alex-aprm/TeslaAmbientLight/images/connector-door3.png

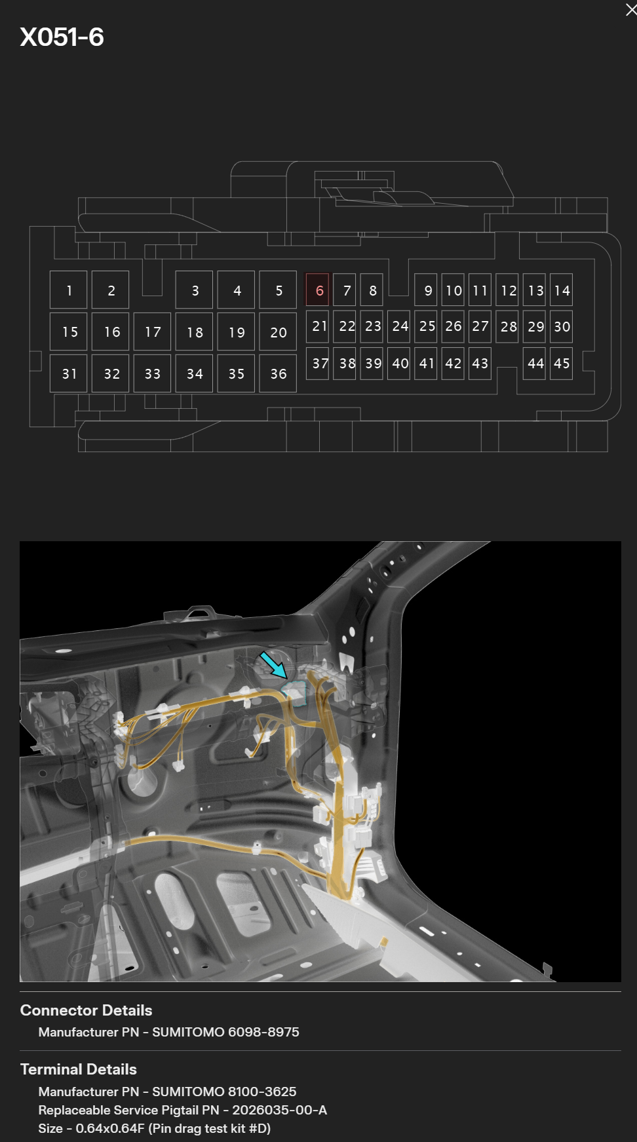
images/connector-door3.png
