alex-aprm/TeslaAmbientLight/images/door-wiring.png

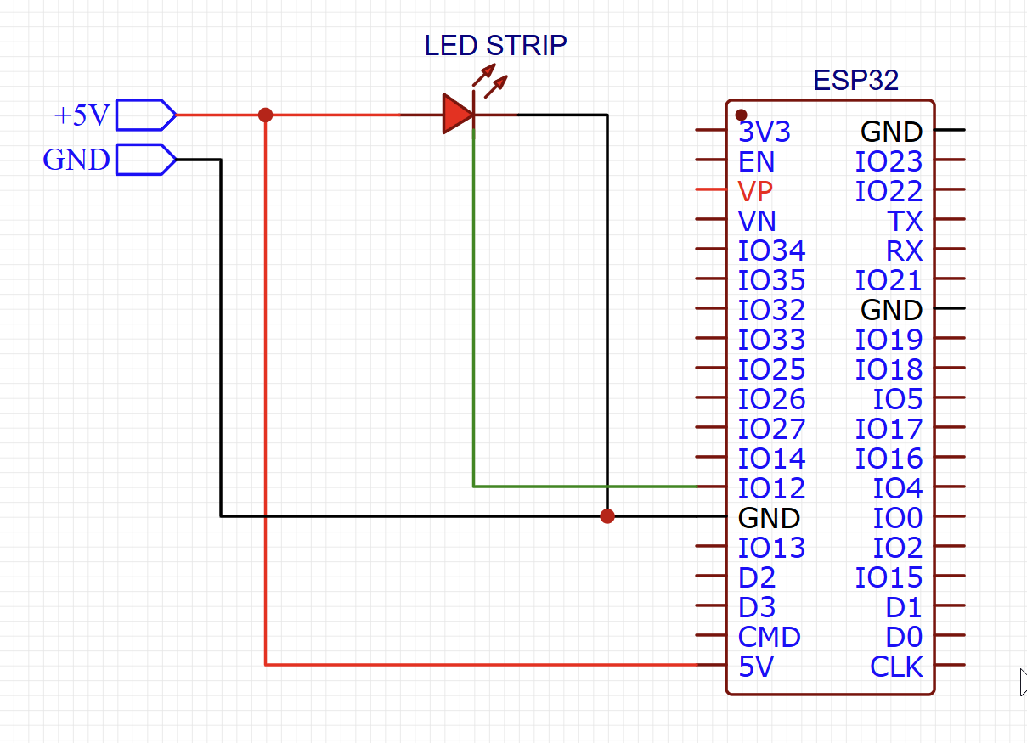
images/door-wiring.png
