alex-aprm/TeslaAmbientLight/images/master-wiring.png

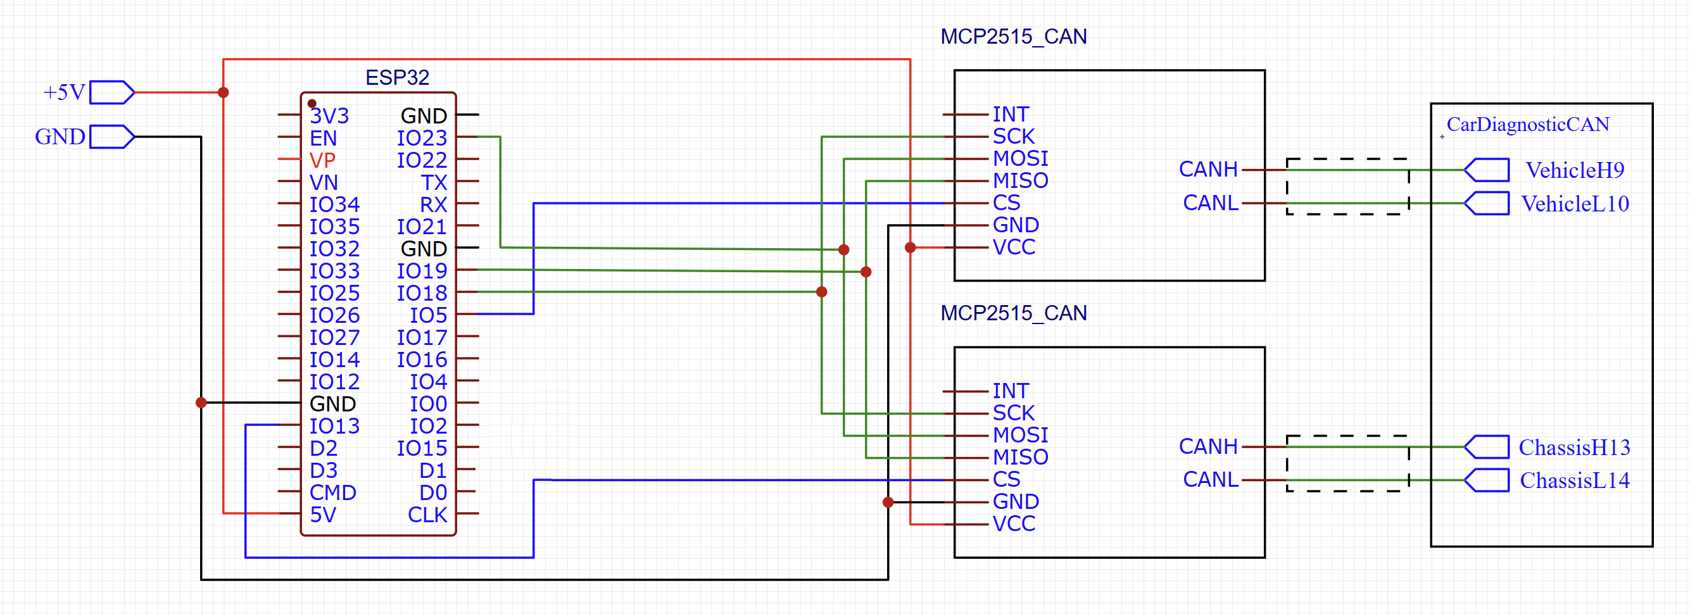
images/master-wiring.png
