alex-aprm/TeslaAmbientLight/Car.h

#ifndef CAR_H
#define CAR_H
#include <mcp_can.h>
#include <Arduino.h>
#include "driver/twai.h"

enum Gear : byte {
  GEAR_UNKNOWN,
  GEAR_PARK,
  GEAR_REAR,
  GEAR_NEUTRAL,
  GEAR_DRIVE
};

class Car {
public:
  Car();
  void init(byte v_pin, byte c_pin);
  void initAS(byte c_pin, byte v_rx_pin, byte v_tx_pin);
  void process();
  byte brightness = 10;
  // Mirrors the car's "Ambient Light" setting from chassis CAN 0x273 bit0.
  // When the user turns ambient light off in the car UI, the strips fade out.
  // RWD trims without the setting in the UI may not transmit the bit at all
  // (or transmit it as always-zero) — set useAmbientLightSetting = false in
  // setup() on those cars to keep the strips on whenever the display is on.
  bool ambientLight = true;
  bool useAmbientLightSetting = true;
  bool displayOn = false;
  bool turningLeft = false;
  bool turningLeftLight = false;
  bool turningRight = false;
  bool turningRightLight = false;
  bool openFrunkWithDoor = false;
  bool blindSpotLeft = false;
  bool blindSpotRight = false;
  bool blindSpotLeftAlert = false;
  bool blindSpotRightAlert = false;
  bool autosteerOn = false;
  bool handsOn = true;
  bool handsOnRequired = false;
  bool handsOnWarning = false;
  bool handsOnAlert = false;
  Gear gear;
  bool doorOpen[4] = { false, false, false, false };
  bool frunkOpen = false;
  bool doorHandlePull[2] = { false, false };
  void openFrunk();
  void unlock();
  void unlockRemote();
  void wakeup();
private:
  bool _v_enabled = false;
  bool _c_enabled = false;
  bool _v_twai_enabled = false;
  MCP_CAN* _VCAN;
  MCP_CAN* _CCAN;
  bool _doorHandlePull = false;
  unsigned long _doorHandlePullMs;
  byte _doorHandlePullCount = 0;
  unsigned long _frunkOpenMs;
  unsigned long _doorChanged;
  unsigned char _vehicleControlFrame[8] = { 0, 0, 0, 0, 0, 0, 0, 0 };
  void _processRightDoors(unsigned char len, unsigned char data[]);
  void _processLeftDoors(unsigned char len, unsigned char data[]);
  void _processDisplayOn(unsigned char len, unsigned char data[]);
  void _processLights(unsigned char len, unsigned char data[]);
  void _processAutopilot(unsigned char len, unsigned char data[]);
  void _processVehicleControl(unsigned char len, unsigned char data[]);
  void _processVehicleStatus(unsigned char len, unsigned char data[]);
  void _processGear(unsigned char len, unsigned char data[]);
  void _monitor(long unsigned int rxId, unsigned char len, unsigned char rxBuf[]);
  void _printMessage(unsigned char len, unsigned char data[], bool out);
  void _handle_twai_rx_message(twai_message_t &message);
};
#endif
