alex-aprm/TeslaAmbientLight/(commit log)

2024-10-25 Blind spot fixes, rear doors fixes, brightness adjustment
    [Car.cpp, TeslaAmbientLight.ino]
2024-11-13 Refactoring, mirror lights support, gear support, foot light support (WIP)
2024-11-16 Footwell OEM LED support, refactoring
2024-11-17 New wiring diagrams
2024-11-19 Changed right rear door connector
2024-12-11 Fixed blind spot issue
    [DoorLight.cpp]
2025-04-30 Some new boards support
2025-05-05 ESP AUTOSPORT board support, 3.20 board manager support, always on fixes
    [Car.cpp, Car.h, CarLight.cpp, DoorLight.cpp, FootLight.cpp, FootLight.h, TeslaAmbientLight.ino]
2025-05-06 Added missing external wifi
    [TeslaAmbientLight.ino]
2025-05-06 External wifi mess fix
    [TeslaAmbientLight.ino]
2025-06-08 Pocket led address mode, confused lines fixes
    [Car.cpp, CarLight.cpp, CarLight.h, DoorLight.cpp, DoorLight.h, TeslaAmbientLight.ino]
2026-04-30 Fix fade clamp / UDP age decode, expand README, mirror tweak
    - DoorLight: assignment fix in _fadeColor (was a no-op ==), so color
    transitions actually clamp to target instead of overshooting.
    - CarLight: decode UDP age field with little-endian shifts on unsigned
    bytes instead of pow(255, i) on signed char, which corrupted any
    byte >= 128 and used the wrong base.
    - MirrorLight: TURNING_BLIND_SPOT now uses the same center-spot range
    as BLIND_SPOT, just in red.
    - README: add Boards section (master variants + slave pin maps), a
    Passwords section warning users to change defaults before flashing,
    a Features list of what's actually shipped, and an Architecture
    section with CAN-ID tabl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
    [CarLight.cpp, DoorLight.cpp, MirrorLight.cpp]
2026-04-30 Read ambient-light setting from chassis CAN 0x273
    Decode bit 0 of byte 5 in the vehicle-control frame as the car's
    "Ambient Light" toggle. CarLight already gates the strips on
    car.ambientLight, so the strips now fade out when the driver turns
    the setting off in the car UI.
    Move the 0x273 dispatch from MCP2515 process() into the TWAI
    _handle_twai_rx_message — chassis CAN goes through TWAI on this
    build path now.
    Add useAmbientLightSetting (default true) so RWD trims that don't
    have the setting in the UI — and may not transmit the bit, or
    transmit it as always-zero — can keep the strips on by setting it
    to false in setup().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
2026-04-30 Use #if AUTOSPORT_ESP32 so the boolean value actually takes effect
    The macro was being tested with #ifdef, which is true regardless of
    the value — so #define AUTOSPORT_ESP32 false still selected the AS
    board branch. Switch to #if so the false case picks the
    plain-ESP32 + 2× MCP2515 wiring as intended.
    Update the README Boards section accordingly.
2026-04-30 README: add Flashing section with two-phase role-burn flow
    Explain the per-node provisioning flash (saveRoleToEEPROM = true,
    edit role per node, USB flash five times) followed by the
    ongoing flash flow (saveRoleToEEPROM = false, one binary across
    all nodes, OTA from then on).
